ethandoddo/MECH5720_MajorProject/Pitch/sections/01_concept.tex

\vspace{0.5em}
\noindent\textbf{1. Team and roles.} \
\textbf{All four:} research into aperture design methods and validation, experimental data capture, report writing and presentation. \
\textbf{Ethan:} aperture design, integration and further code development. \textbf{Emma and Jayden:} hardware design, integration and code tidying. \textbf{Has:} aperture design and the final GitHub README.

\vspace{0.4em}
\noindent\textbf{2. Goal.}
 \noindent To put a transmissive LCD in the optical path of a Canon DSLR so that software sets the aperture pattern for every frame. The requirement is a dynamic aperture, meaning the aperture pattern changes from one frame to the next. The test is two consecutive frames of a static scene with a different pattern on each, so the frames stay aligned to the pixel.

\vspace{\baselineskip}
 \noindent Once the gates pass, four secondary goals follow, all built from the dynamic aperture. The first is depth estimation. The two frames carry the patterns of a coded aperture pair [\rl{G6}] and a joint deconvolution of the pair recovers a depth map and an all-in-focus image. The second is post-capture refocus, which extends the capture to nine frames, each opening a different sub-aperture [\rl{G3}]. The third is custom bokeh, which repeats the dynamic aperture test with aperture shapes we design ourselves. The fourth is a flutter shutter, which switches the pattern within one exposure. Gate 3 measures whether the panel switches fast enough.

\vspace{\baselineskip}
 \noindent We found a hobbyist build that fits an LCD iris to a camera lens [\rl{G1}, \rl{G2}] and published research that uses controllable apertures for coded imaging [\rl{G4}, \rl{G5}]. Together they show that every part of this plan has been done before. What remains untested is combining them in one camera.

\vspace{0.4em}
\noindent\textbf{3. Approach.}
A defocused point images as a scaled copy of the aperture. That holds only near the lens pupil, so mask position matters.
\begin{itemize}\setlength\itemsep{0pt}
    \item \textbf{Stage 1:} the panel sits against the front of the lens, near the entrance pupil. Edge points see a clipped pattern, so all tests use the image centre.
    \item \textbf{Stage 2}, only if Stage~1 passes all three gates: the panel moves into a slot cut in the 25\,mm extension tube, behind the exit pupil, where it starts to act as a light-field mask. The same patterns at both positions measure the difference.
    \item \textbf{Panel and control:} stripping the backlight and diffuser leaves the transmissive cell. A Raspberry Pi drives it over SPI and fires the shutter.
    \item \textbf{Processing:} a point source at 700, 1000 and 1300\,mm gives PSFs for the open disc and both coded patterns (Lab~3 protocol). Each image patch takes the depth whose PSF pair best explains both frames after Wiener deconvolution. Every capture set includes an open-disc control frame.
\end{itemize}

\noindent\textbf{4. Success criteria.}
\begin{itemize}\setlength\itemsep{0pt}
    \item \textbf{Gate 1, panel acts as an aperture:} a defocused point source matches the displayed pattern with normalised cross-correlation (NCC) $\geq 0.8$. Transmission loss stays at or below 3 stops.
    \item \textbf{Gate 2, coded pair PSFs:} PSF width grows with defocus. The two coded MTFs share no zeros in the target band, while the open-disc MTF shows its expected zeros.
    \item \textbf{Gate 3, dynamic aperture (the requirement):} two consecutive frames of a static point source show the two coded patterns at NCC $\geq 0.8$ each. Open-disc control frames before and after register within one pixel. The measured switching time decides whether a flutter shutter is possible.
    \item \textbf{Depth estimation, first application}, with textured targets at 700, 1000 and 1300\,mm: RMS depth error below 10\,\% of true distance. The all-in-focus image beats the open disc stopped down to the same depth of field on structural similarity index measure (SSIM).
    \item \textbf{Post-capture refocus:} each target reaches peak SSIM against its in-focus reference at its true depth.
    \item \textbf{Custom bokeh:} every out-of-focus highlight reaches NCC $\geq 0.8$ against its displayed shape.
    \item \textbf{Flutter shutter}, only if the switching time allows a useful code in one exposure: deblurring narrows edge width on a moving target.
\end{itemize}

\noindent\textbf{5. Fallback.}
All validation captures at the front of the lens happen before the panel goes into the extension tube. If tube integration damages the LCD panel, those captures form the final deliverable and still address all four goals. If the measured switching time is too slow for a useful code within one exposure, the flutter shutter drops out and the deliverable is the other three goals. Depth estimation is the minimum deliverable, since it needs only two frames and the coded pair.

\vspace{0.4em}
\noindent\textbf{6. Hardware.}\
\textbf{Team builds:} front-of-lens panel mount, slotted 25\,mm extension tube for Stage~2, laser-cut fallback masks, Raspberry Pi display and capture code.\
\textbf{On the loan list:} Adafruit 1.8-inch colour TFT, $128 \times 160$ (\url{https://www.adafruit.com/product/358}). Stripping the backlight is permanent, so the team asks for approval to modify one of the six available.\
\textbf{Already supplied:} Raspberry Pi and the Lab~3 point-source PSF setup. The Canon DSLR and EF lens belong to a team member.\
\textbf{To be acquired on the team's behalf:} three-piece Canon EF and EF-S macro extension tube set, AUD\,\$47.29 (\url{https://www.ebay.com.au/itm/402972099293}), which the team returns after the project. The Stage~2 slot is permanent.
\newpage
