ethandoddo/MECH5720_MajorProject/Report/sections/00_abstract.tex

% Abstract. The brief asks for no jargon, no acronyms, no citations and the key numbers.
% Every red number is a placeholder until the experiments run.
\begin{itemize}
\item We made a camera aperture programmable. We mounted a stripped colour display in front of the lens and an Arduino drew a new pattern on it before each frame.
\item Against laser-cut card masks of the same shapes, the display passed \tbd{X}\,\% of the light and took \tbd{X} milliseconds to switch. Frames stayed within \tbd{0.X} pixels of each other, against \tbd{X} pixels when we swapped card masks by hand.
\item We measured depth to within \tbd{X}\,\% of distance, refocused after capture and cut motion-blur error by \tbd{X}\,\% in dim light.
\item The display suits tasks where the pattern must change between frames. A card mask suits one fixed shape, since it passes more light.
\end{itemize}
