ethandoddo/MECH5720_MajorProject/Report/sections/02_literature_review.tex

% Literature review. The brief: very brief, papers and no websites, and say what we borrow or adapt.
% Plan, one short paragraph each, about 300 words in total. Every key below is in references.bib.
%  1. Coded apertures for depth and deblurring: levin2007coded (one mask cut from card, sparse prior,
%     the Lab 3 mask), zhou2009good (aperture design for deblurring), zhou2009pairs and zhou2011pairsijcv
%     (the pair we display, photomasks in two lenses swapped between shots, a 5 px shift to correct),
%     pentland1987dfd (depth from defocus).
%  2. Programmable apertures: liang2008programmable (liquid crystal array in the aperture, sub-aperture scan
%     and multiplexing, the refocus method), nagahara2010lcos (liquid crystal on silicon with relay optics,
%     argues a transmissive LCD loses too much light and diffracts), bimber2011adaptive (hobby LCD at the
%     aperture plane of a Canon lens, 7:1 contrast, 1/40 s switching), zomet2006lensless (off-the-shelf LCD as
%     a lensless aperture, dark-frame subtraction for leakage), dietz2021lcaperture (colour TFT in front of a
%     lens, 4.7 stops, diffraction ghosts).
%  3. Light fields and refocus: levoy1996lightfield, ng2005lightfield (shift-and-add), veeraraghavan2007dappled.
%  4. Coded exposure: raskar2006coded, agrawal2009codes (code design), cossairt2013when (gains need low light).
%  5. When coding pays: schechner2007multiplexing (multiplexing gain under read noise, Lectures 2A and 3A),
%     mitra2014framework (SNR gain against J/sigma_r^2 with a signal prior, the plot on Lecture 3A slide 17).
%  Lectures 5 and 7 also cite these, not yet in references.bib: Levin et al. 2009 (blind deconvolution, picks
%  the kernel that best explains the photo), FlatCam (Asif et al.), DiffuserCam (Antipa et al. 2018) and
%  PhlatCam (Boominathan et al. 2020, mask optimised for the task, a future-work link for a programmable aperture).
%  Close by stating which ideas we take from which paper. Do not claim novelty over them.
\section{Literature Review}\label{sec:lit}

\tbd{To write. Cite papers alone. See the plan in the comments above.}
