ethandoddo/MECH5720_MajorProject/Report/sections/06_conclusion.tex

% Conclusions and future work. The brief: summarise the work and say what we would do with two more months.
% Keep the summary to the measured numbers. Do not restate the introduction.
% Future work candidates:
%  - multiplexed sub-aperture codes (Liang et al. 2008) for more light per refocus frame
%  - a monochrome panel with no colour filter, which removes 1.6 stops and most of the grid copies
%  - relay optics that image the stop onto the panel (Nagahara et al. 2010), which removes field dependence
%  - a mirrorless body, whose adapter gap holds a mask behind the lens with infinity focus kept
%    (the hobbyist build in PetaPixel, February 2026, did this with a Nokia display)
%  - starting the flutter code from the hot-shoe sync contact through a hot-shoe adapter
%  - dark-frame subtraction for every coded capture if leakage proves to limit depth
\section{Conclusions and Future Work}\label{sec:conclusion}

\tbd{To write.}
