ethandoddo/MECH5720_MajorProject/Pitch/pitch.tex

% main.tex
\documentclass[10pt,a4paper]{article}

\usepackage{silence}
\WarningFilter{siunitx}{Detected the "physics" package}
\usepackage{preamble} % Ensure you have this package or comment it out if not needed
\usepackage{graphicx}
\usepackage{placeins} % Added to control figure floating
\usepackage{float}
\usepackage{ifthen}
\usepackage{textcomp}
\usepackage{pgfgantt}
\usepackage{geometry}
\usepackage{url}
% Let long order-page URLs break anywhere rather than run into the margin
\makeatletter
\g@addto@macro\UrlBreaks{\UrlOrds}
\g@addto@macro\UrlBreaks{%
  \do\a\do\b\do\c\do\d\do\e\do\f\do\g\do\h\do\i\do\j\do\k\do\l\do\m%
  \do\n\do\o\do\p\do\q\do\r\do\s\do\t\do\u\do\v\do\w\do\x\do\y\do\z%
  \do\A\do\B\do\C\do\D\do\E\do\F\do\G\do\H\do\I\do\J\do\K\do\L\do\M%
  \do\N\do\O\do\P\do\Q\do\R\do\S\do\T\do\U\do\V\do\W\do\X\do\Y\do\Z%
  \do\0\do\1\do\2\do\3\do\4\do\5\do\6\do\7\do\8\do\9}
\makeatother
\usepackage{hyperref}
% Reference tag in the body that jumps to that entry in the References list
\newcommand{\rl}[1]{\hyperref[ref:#1]{#1}}
\geometry{
    a4paper,
    left=12mm,
    right=12mm,
    top=2mm,
    bottom=2mm,
}

% Handle missing figures gracefully while keeping black borders on existing ones
\let\origincludegraphics\includegraphics
\renewcommand{\includegraphics}[2][]{%
  \setlength{\fboxsep}{0pt}%
  \setlength{\fboxrule}{0.5pt}%
  \IfFileExists{#2}{%
    \fbox{\origincludegraphics[#1]{#2}}%
  }{%
    \fbox{\begin{minipage}[c][3cm][c]{\linewidth}\centering\scriptsize\ttfamily Missing:\\\detokenize{#2}\end{minipage}}%
  }%
}

\pagestyle{empty}
\linespread{1}

\begin{document}

\noindent\makebox[\textwidth][s]{{\LARGE \bfseries Major Project Pitch:} {\Large \color{black!70} Dynamic aperture control with a transmissive LCD }}\\[0.3cm]
\noindent
\begin{tabular*}{\textwidth}{@{\extracolsep{\fill}} c c c c @{}}
    490480278 & 500468995 & 530477149 & 530504892 \\
\end{tabular*}\vspace{0.1cm}
\hrule
\input{sections/01_concept}
\input{sections/02_gantt}
\input{sections/03_appendix}

\end{document}
