ethandoddo/MECH5720_MajorProject/Pitch/sections/02_gantt.tex

% \vspace{-2em}
% \section*{Project schedule \& division of labour}

% \begin{center}
% \definecolor{coral}{HTML}{FF7F50}
% \resizebox{\textwidth}{!}{
% \begin{ganttchart}[
%     x unit=1.6cm,
%     y unit title=0.6cm,
%     y unit chart=0.5cm,
%     title label font=\small\bfseries,
%     title label node/.append style={text height=1.5ex, text depth=0ex, anchor=center},
%     bar label font=\footnotesize,
%     bar label node/.append style={align=left, text width=4.5cm},
%     milestone label font=\footnotesize\itshape,
%     milestone label node/.append style={align=left, text width=4.5cm},
%     bar height=0.6,
%     bar top shift=0.2,
%     bar/.append style={fill=blue!40},
%     milestone/.append style={fill=green!70, draw=green!40!black, xscale=0.25, yscale=0.5},
%     canvas/.append style={fill=none},
%     vgrid={*1{draw=black!10}}, hgrid]{1}{7}
%     \gantttitle{MSB}{1} \gantttitle{W8}{1} \gantttitle{W9}{1} \gantttitle{W10}{1} \gantttitle{W11}{1} \gantttitle{W12}{1} \gantttitle{W13}{1} \\
%     \node[anchor=east, font=\small\bfseries, text height=1.5ex, text depth=0ex] at (0, -0.15cm) {Week};

%     \ganttset{bar/.append style={fill=blue!40}}
%     \ganttbar[name=t1]{\textbf{Phase 1}}{1}{2} \\

%     \ganttset{bar/.append style={fill=blue!10}}
%     \ganttbar[name=p1]{Subtask 1.1}{1}{1} \\
%     \ganttbar[name=p2]{Subtask 1.2}{1}{2} \\

%     \ganttset{bar/.append style={fill=coral!70}}
%     \ganttbar[name=t2]{\textbf{Phase 2}}{2}{4} \\

%     \ganttset{bar/.append style={fill=blue!10}}
%     \ganttbar[name=p3]{Subtask 2.1}{2}{3} \\
%     \ganttbar[name=p4]{Subtask 2.2}{3}{4} \\

%     \ganttset{bar/.append style={fill=blue!40}}
%     \ganttbar[name=t3]{\textbf{Phase 3}}{3}{5} \\

%     \ganttset{bar/.append style={fill=blue!10}}
%     \ganttbar[name=p5]{Subtask 3.1}{3}{4} \\
%     \ganttbar[name=p6]{Subtask 3.2}{4}{5} \\

%     \ganttset{bar/.append style={fill=coral!70}}
%     \ganttbar[name=t4]{\textbf{Phase 4}}{5}{6} \\

%     \ganttset{bar/.append style={fill=blue!10}}
%     \ganttbar[name=p7]{Subtask 4.1}{5}{6} \\

%     \ganttset{bar/.append style={fill=blue!40}}
%     \ganttbar[name=t5]{\textbf{Phase 5}}{6}{7} \\

%     \ganttset{bar/.append style={fill=blue!10}}
%     \ganttbar[name=p8]{Subtask 5.1}{6}{6} \\
%     \ganttbar[name=p9]{Subtask 5.2}{7}{7} \\

%     \ganttmilestone[name=m1]{\textbf{D1: Project Pitch}}{2} \\
%     \ganttmilestone[name=m2]{\textbf{D2: Lightning Talk}}{7} \\
%     \ganttmilestone[name=m3]{\textbf{D3: Final Report}}{7}

%     \ganttlink{t1}{t2}
%     \ganttlink{t2}{t3}
%     \ganttlink{t3}{t4}
%     \ganttlink{t4}{t5}

% \end{ganttchart}
% }
% \end{center}

% \vspace{0.5em}
% \textbf{Workload distribution:}
% [Ensure you briefly justify the workload distribution above and confirm that all members contribute roughly equally to the design, implementation, and reporting phases of the project.]
