ethandoddo/MECH5720_MajorProject/code/assets/sprites/binary/knight/knight_binary_walk.gif

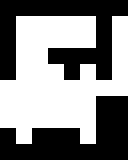
code/assets/sprites/binary/knight/knight_binary_walk.gif
