ethandoddo/MECH5720_MajorProject/code/assets/sprites/binary/link/link_binary_attack_2.png

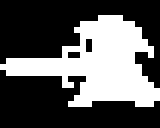
code/assets/sprites/binary/link/link_binary_attack_2.png
