ethandoddo/MECH5720_MajorProject/code/assets/sprites/binary/link/link_binary_walk.gif

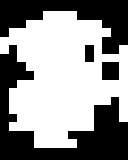
code/assets/sprites/binary/link/link_binary_walk.gif
