ethandoddo/MECH5720_MajorProject/code/assets/sprites/binary/mario/mario_binary_walk.gif

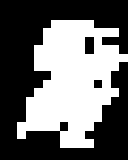
code/assets/sprites/binary/mario/mario_binary_walk.gif
