ethandoddo/MECH5720_MajorProject/code/assets/sprites/binary/mario/mario_binary_walk_2.png

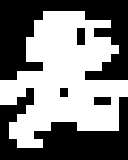
code/assets/sprites/binary/mario/mario_binary_walk_2.png
