ethandoddo/MECH5720_MajorProject/code/assets/sprites/binary/terraria/terraria_binary_mine.gif

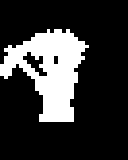
code/assets/sprites/binary/terraria/terraria_binary_mine.gif
