ethandoddo/MECH5720_MajorProject/code/assets/sprites/binary/terraria/terraria_binary_mine_2.png

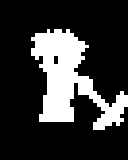
code/assets/sprites/binary/terraria/terraria_binary_mine_2.png
