ethandoddo/MECH5720_MajorProject/code/assets/sprites/grey/knight/knight_grey_walk.gif

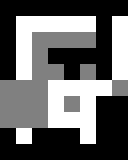
code/assets/sprites/grey/knight/knight_grey_walk.gif
