ethandoddo/MECH5720_MajorProject/code/assets/sprites/grey/link/link_grey_attack.gif

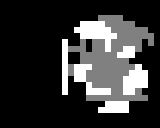
code/assets/sprites/grey/link/link_grey_attack.gif
