ethandoddo/MECH5720_MajorProject/code/assets/sprites/grey/link/link_grey_walk.gif

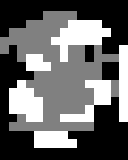
code/assets/sprites/grey/link/link_grey_walk.gif
