ethandoddo/MECH5720_MajorProject/code/assets/sprites/grey/link/link_grey_walk_2.png

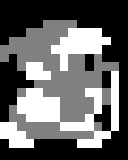
code/assets/sprites/grey/link/link_grey_walk_2.png
