ethandoddo/MECH5720_MajorProject/code/captures/bokeh_inside_lens/knight_binary_walk_1_5.5mm_offset_5-49mm.jpg

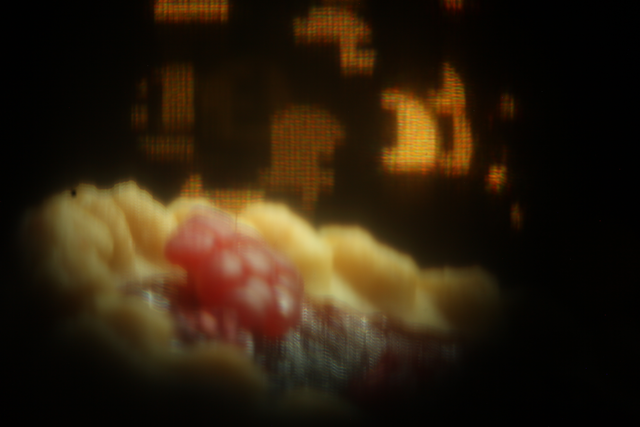
code/captures/bokeh_inside_lens/knight_binary_walk_1_5.5mm_offset_5-49mm.jpg
