ethandoddo/MECH5720_MajorProject/code/captures/bokeh_inside_lens/link_binary_attack_2_5.5mm_offset_5-49mm.jpg

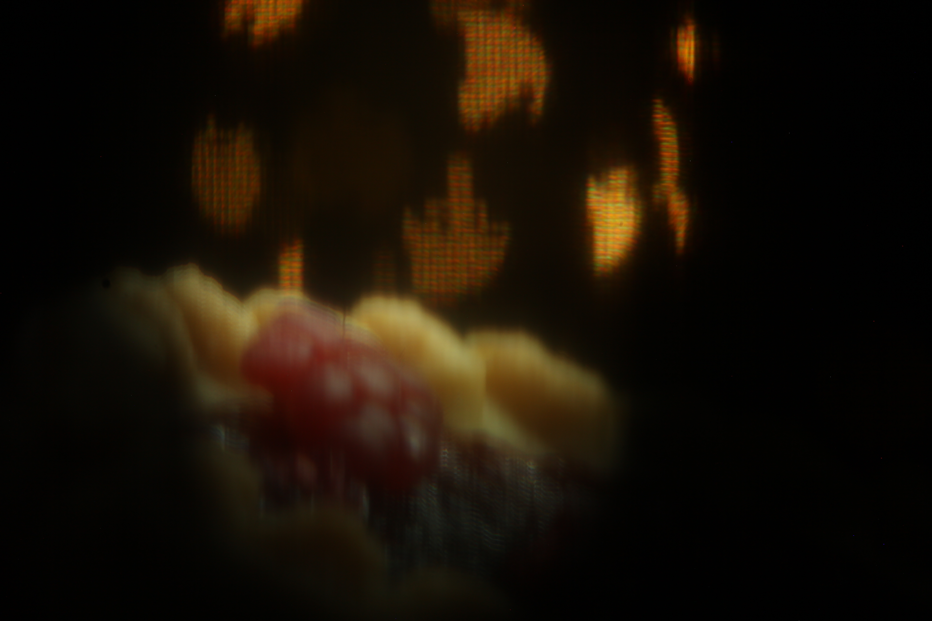
code/captures/bokeh_inside_lens/link_binary_attack_2_5.5mm_offset_5-49mm.jpg
