ethandoddo/MECH5720_MajorProject/code/captures/bokeh_inside_lens/mario_binary_walk_3_5.5mm_offset_5-49mm.jpg

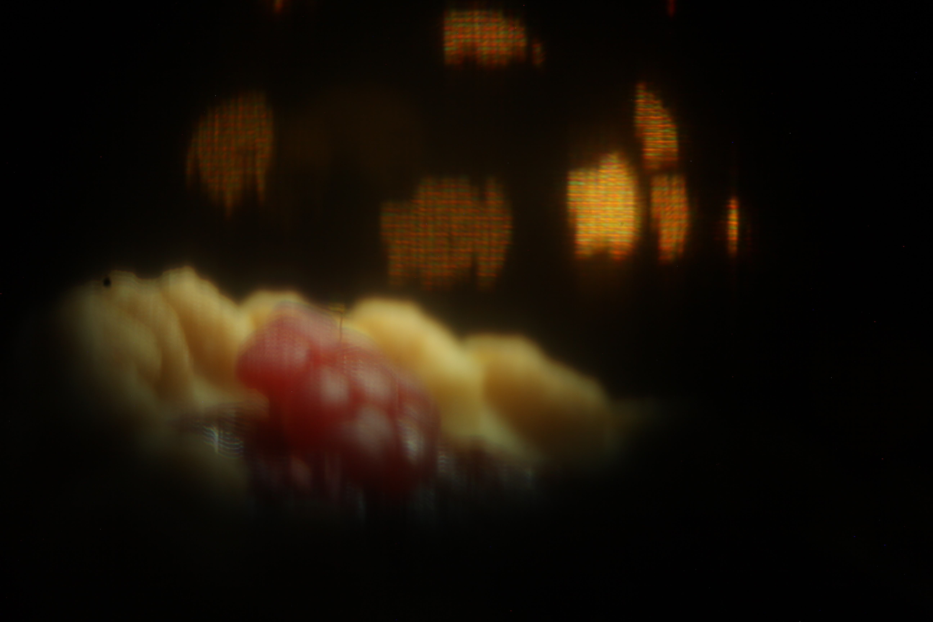
code/captures/bokeh_inside_lens/mario_binary_walk_3_5.5mm_offset_5-49mm.jpg
