ethandoddo/MECH5720_MajorProject/code/captures/bokeh_inside_lens/zhou_a_5.5mm_offset_5-34mm.jpg

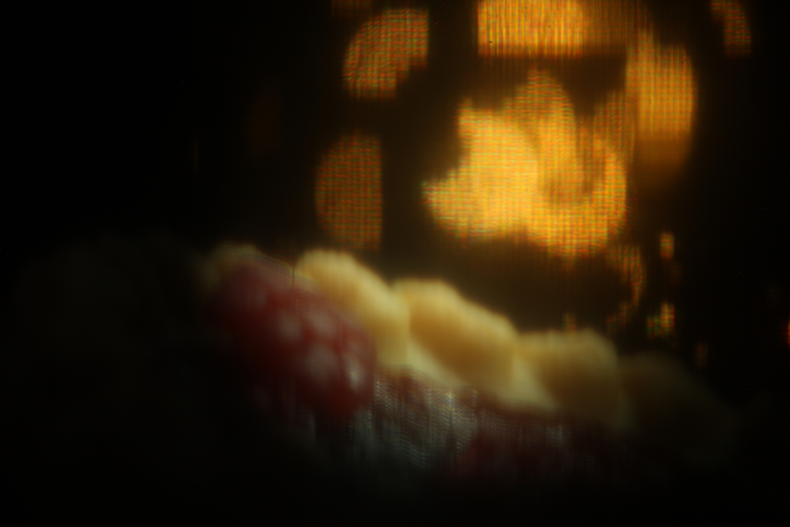
code/captures/bokeh_inside_lens/zhou_a_5.5mm_offset_5-34mm.jpg
