ethandoddo/MECH5720_MajorProject/code/captures/bokeh_outside_lens/knight_binary_walk_1_9.5mm_offset_11-134mm.jpg

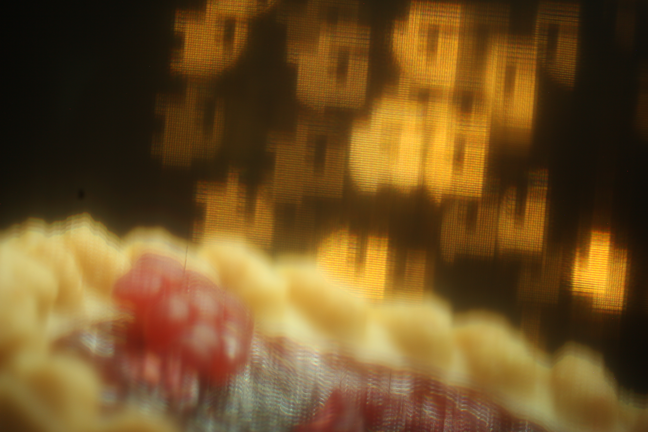
code/captures/bokeh_outside_lens/knight_binary_walk_1_9.5mm_offset_11-134mm.jpg
