ethandoddo/MECH5720_MajorProject/code/captures/bokeh_outside_lens/zhou_b_9.5mm_offset_11-134mm.jpg

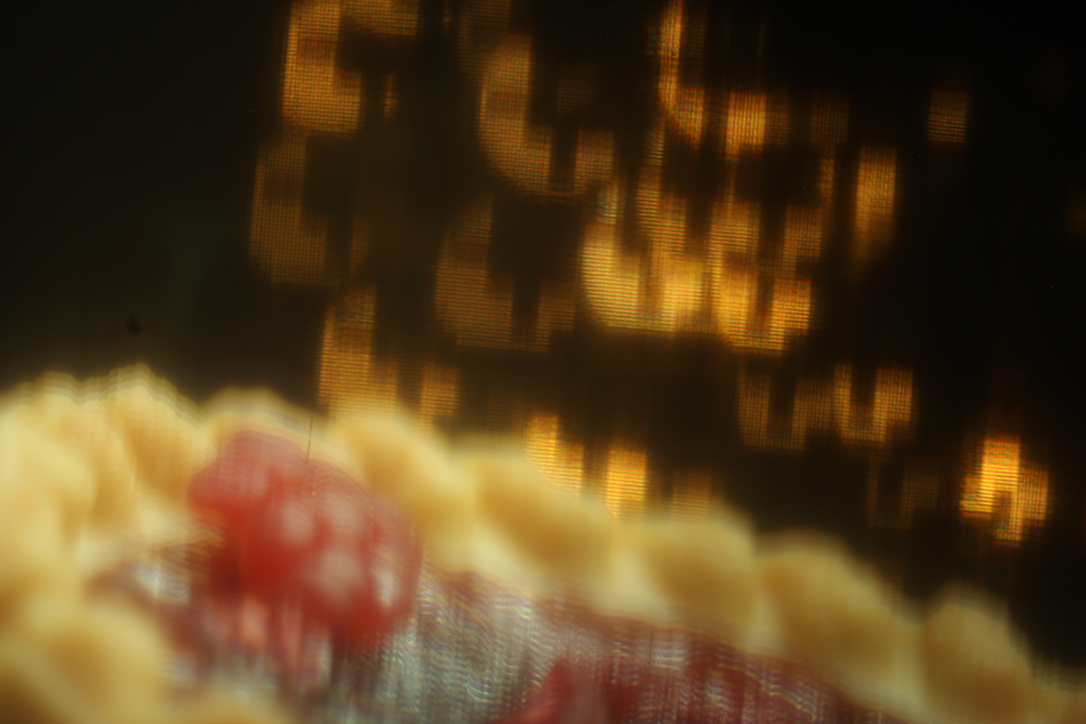
code/captures/bokeh_outside_lens/zhou_b_9.5mm_offset_11-134mm.jpg
