ethandoddo/MECH5720_MajorProject/code/captures/flutter_5s_ISO100_f5.6_inside_lens/f56_run1_lcd_inside/95_baselines.png

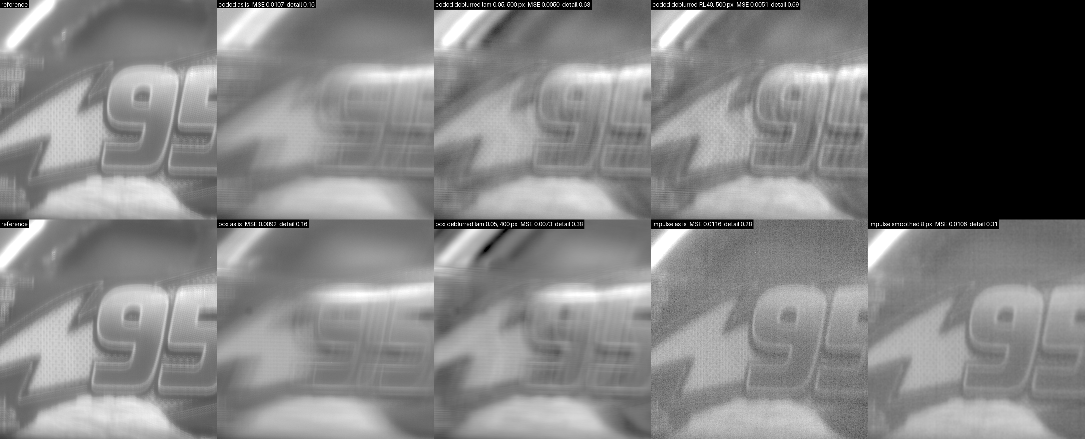
code/captures/flutter_5s_ISO100_f5.6_inside_lens/f56_run1_lcd_inside/95_baselines.png
