ethandoddo/MECH5720_MajorProject/code/captures/flutter_5s_ISO100_f5.6_inside_lens/f56_run1_lcd_inside/f56_run1_lcd_inside_100ms_invert_box.png

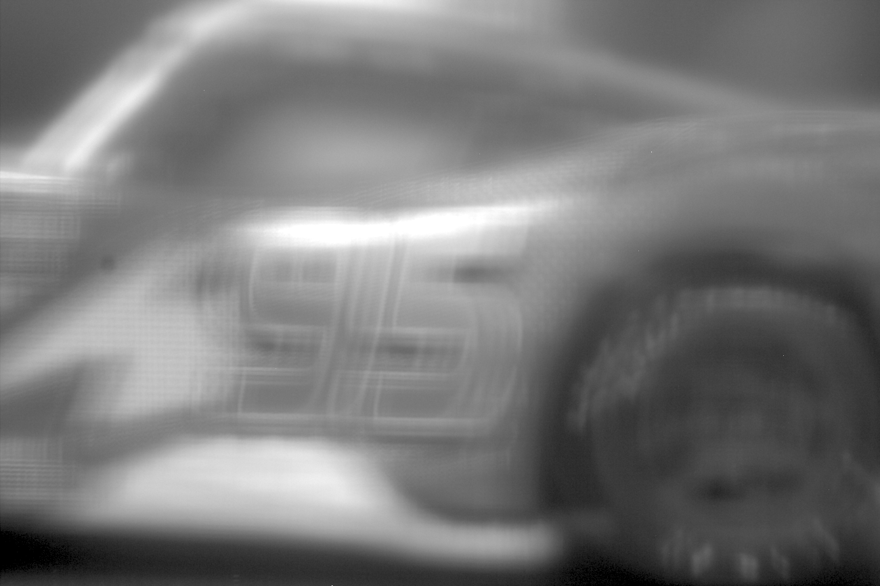
code/captures/flutter_5s_ISO100_f5.6_inside_lens/f56_run1_lcd_inside/f56_run1_lcd_inside_100ms_invert_box.png
