ethandoddo/MECH5720_MajorProject/code/captures/flutter_5s_ISO100_f5.6_outside_lens/95_compare.png

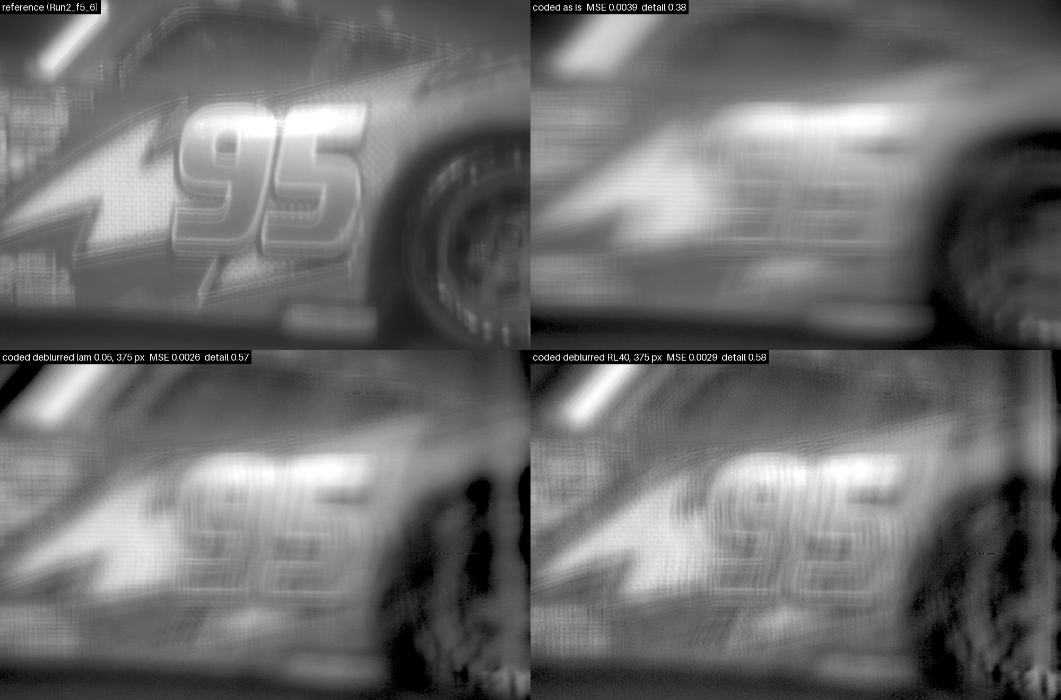
code/captures/flutter_5s_ISO100_f5.6_outside_lens/95_compare.png
