ethandoddo/MECH5720_MajorProject/code/captures/flutter_5s_ISO100_f5.6_outside_lens/deblurred_best_lam0.05_375px.png

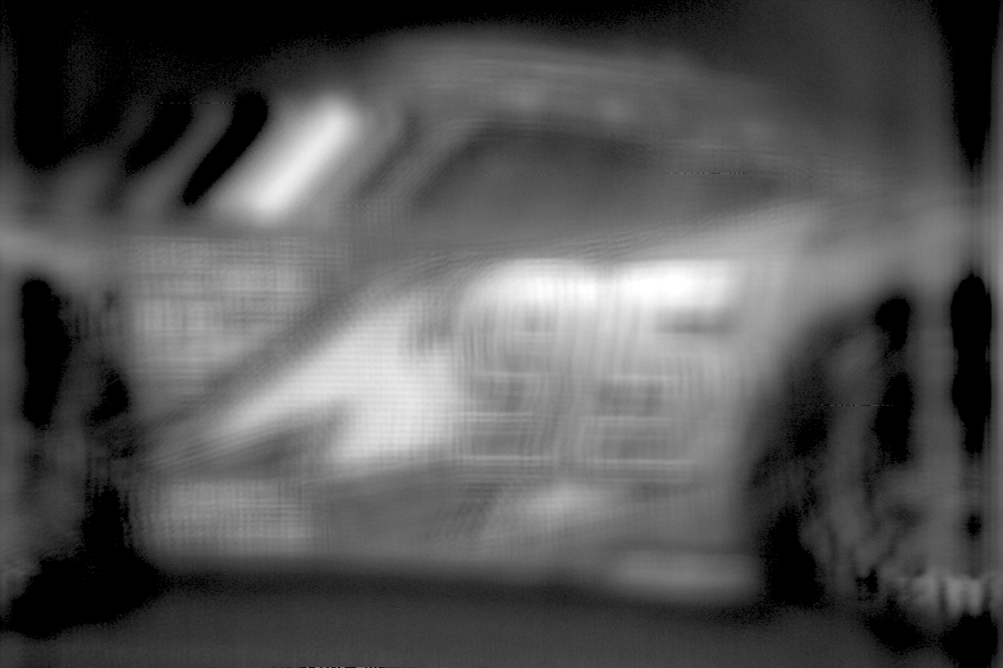
code/captures/flutter_5s_ISO100_f5.6_outside_lens/deblurred_best_lam0.05_375px.png
