ethandoddo/MECH5720_MajorProject/code/captures/flutter_5s_ISO100_f11_inside_lens/f11_run1_lcd_inside_2/compare.png

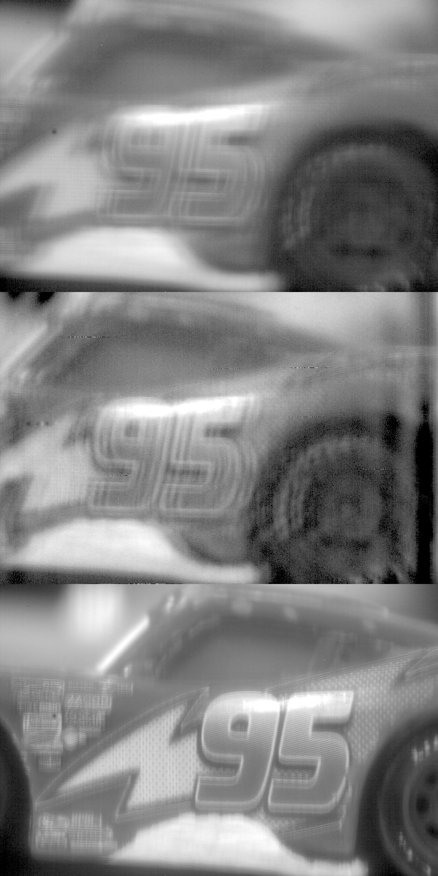
code/captures/flutter_5s_ISO100_f11_inside_lens/f11_run1_lcd_inside_2/compare.png
