ethandoddo/MECH5720_MajorProject/code/captures/flutter_5s_ISO100_f11_inside_lens/f22_run1_lcd_inside/95_baselines.png

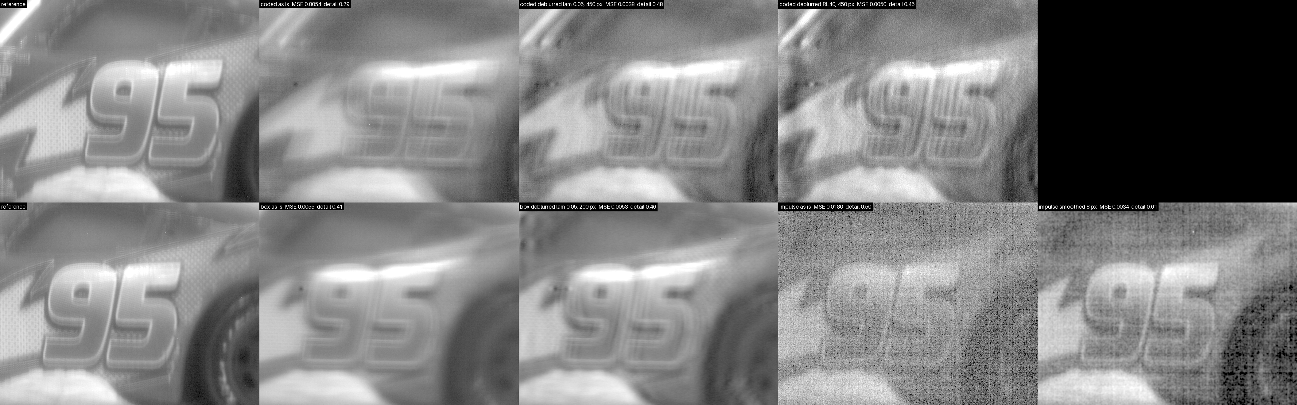
code/captures/flutter_5s_ISO100_f11_inside_lens/f22_run1_lcd_inside/95_baselines.png
