ethandoddo/MECH5720_MajorProject/code/captures/flutter_5s_ISO100_f11_outside_lens/compare.png

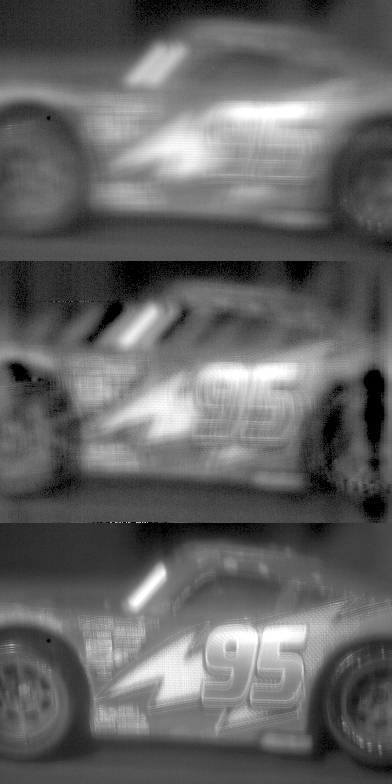
code/captures/flutter_5s_ISO100_f11_outside_lens/compare.png
