ethandoddo/MECH5720_MajorProject/code/captures/flutter_5s_ISO100_f11_outside_lens/deblurred_RL40_475px.png

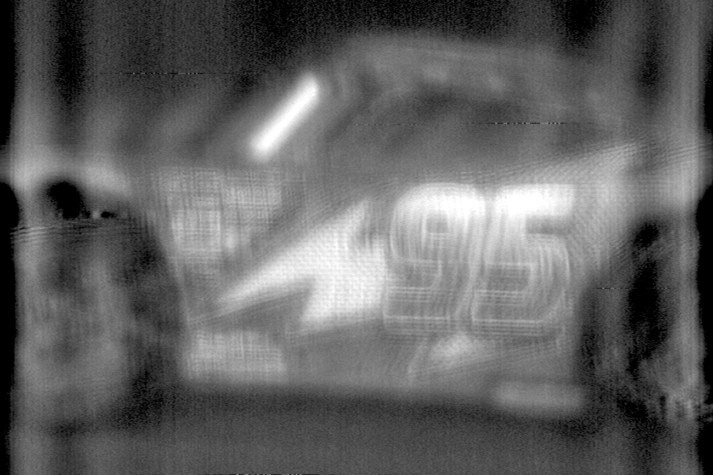
code/captures/flutter_5s_ISO100_f11_outside_lens/deblurred_RL40_475px.png
