ethandoddo/MECH5720_MajorProject/code/captures/flutter_5s_ISO100_f22_inside_lens/f22_inside_lcd_run2/f22_inside_lcd_run2_100ms_invert_coded_lam0.05_400px.png

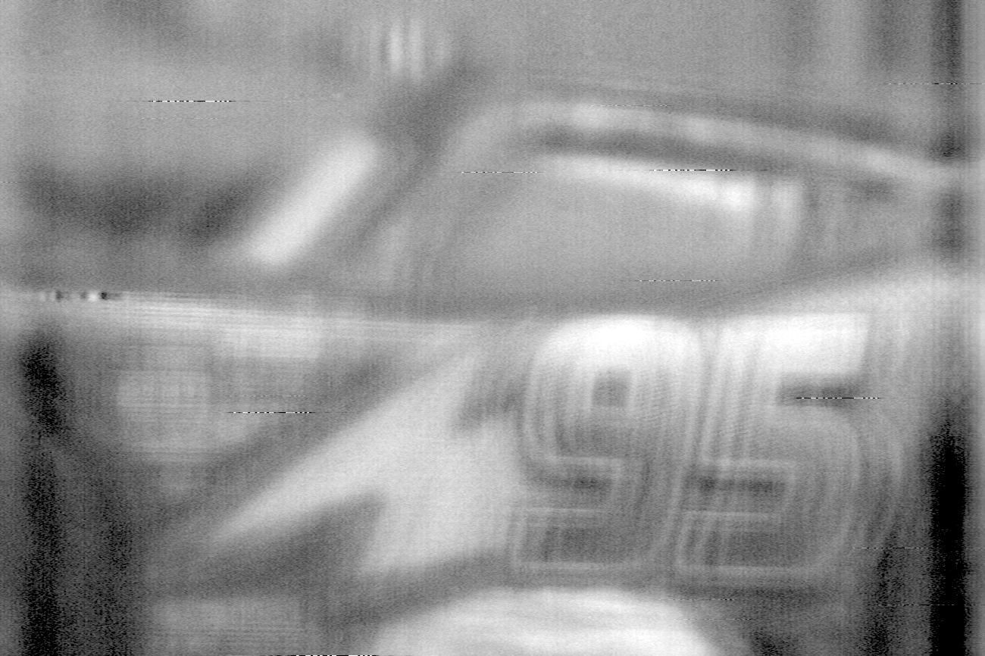
code/captures/flutter_5s_ISO100_f22_inside_lens/f22_inside_lcd_run2/f22_inside_lcd_run2_100ms_invert_coded_lam0.05_400px.png
