ethandoddo/MECH5720_MajorProject/code/captures/flutter_5s_ISO100_f22_inside_lens/f22_lcd_inside/f22_lcd_inside_100ms_invert_box_RL40_200px.png

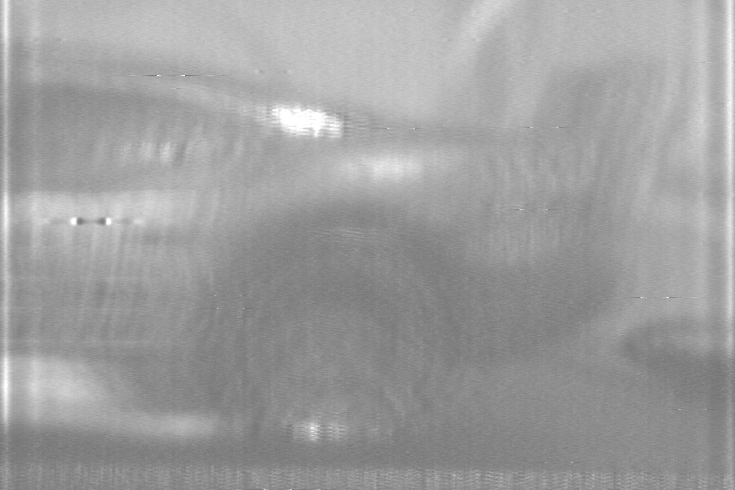
code/captures/flutter_5s_ISO100_f22_inside_lens/f22_lcd_inside/f22_lcd_inside_100ms_invert_box_RL40_200px.png
