ethandoddo/MECH5720_MajorProject/code/captures/flutter_5s_ISO100_f22_outside_lens/deblurred_best_lam0.5_250px.png

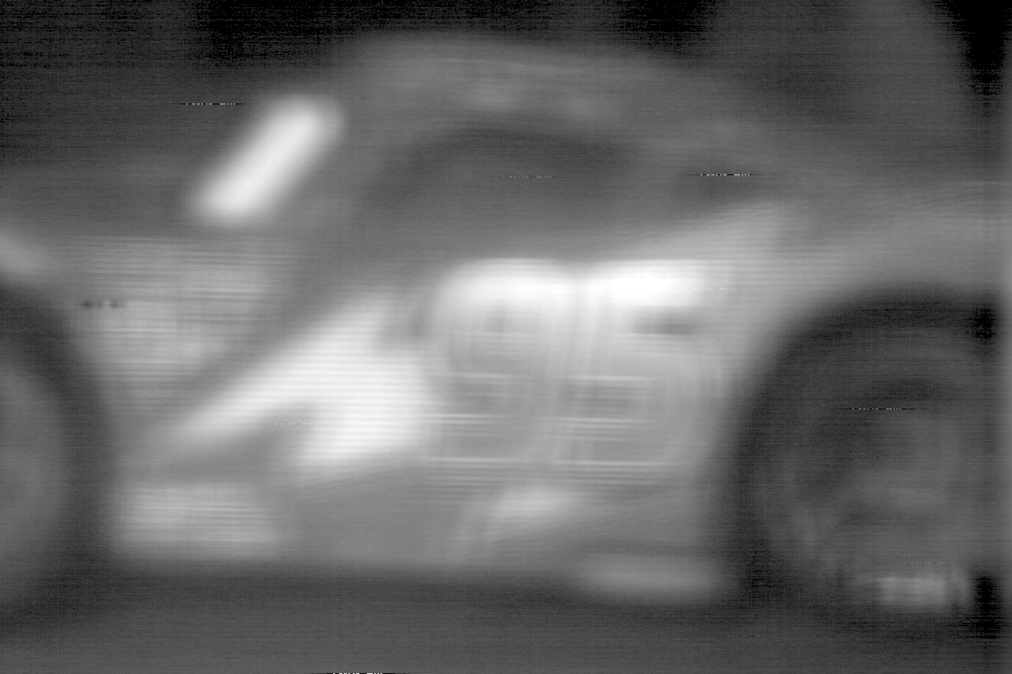
code/captures/flutter_5s_ISO100_f22_outside_lens/deblurred_best_lam0.5_250px.png
