ethandoddo/MECH5720_MajorProject/Pitch/Images/apertures_by_goal.png

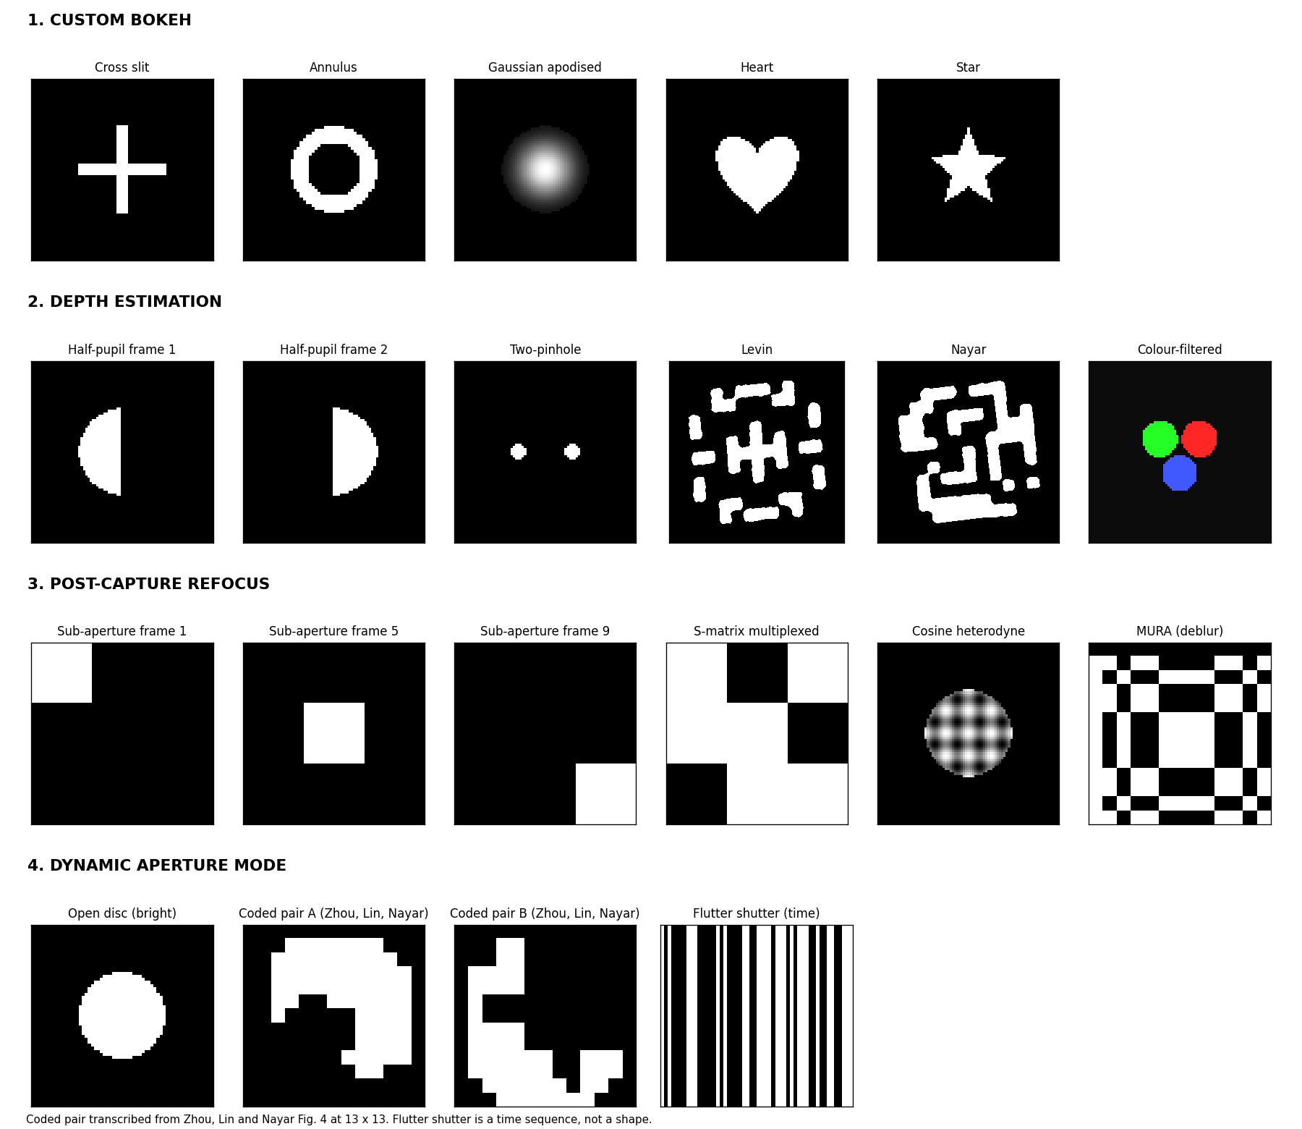
Pitch/Images/apertures_by_goal.png
