ethandoddo/MECH5720_MajorProject/code/aperture/rig/camera.py

"""Camera backends. capture(stem) writes one frame and returns the files it wrote, raw first.

  gphoto  a Canon EOS 60D on USB through the gphoto2 command line tool. The camera
          sits in manual exposure and manual focus, with the file quality set on the
          body. RAW+JPEG on the body gives a CR2 for processing and a JPEG the camera
          view can show at once
  dummy   writes whatever the display is showing as a PNG, so a whole sequence can run
          on a laptop with nothing plugged in

capture_start(stem) runs capture(stem) in its own thread and returns a job whose wait()
gives the files, so the server can read the panel's flutter trace while the shutter is
open. shutter_s() reads the body's shutter speed, which a flutter frame on M needs to be
at least lead + code.
"""
import re
import shutil
import subprocess
import threading
from pathlib import Path

from aperture import config as cfg
from aperture import flutter

RAW_EXT = {".cr2", ".dng", ".nef", ".arw", ".raw"}
SETTING_NAMES = ("iso", "shutterspeed", "aperture")


class CameraError(RuntimeError):
    pass


def shutter_seconds(current):
    """the shutter speed the body reports, in seconds; CameraError when it is not a time, as on B"""
    s = flutter.shutter_s(current)
    if s is None:
        raise CameraError(f"the shutter speed is {current!r}, not a time: turn the mode dial to M")
    return s


class Camera:
    name = "base"

    def capture(self, stem):
        """stem is a path without extension; returns the files written, the raw one first"""
        raise NotImplementedError

    def capture_start(self, stem):
        """capture(stem) in its own thread, so the server can read the panel's flutter trace
        while the shutter is open; returns a job whose wait() gives the files"""
        return ThreadJob(lambda: self.capture(stem))

    def shutter_s(self):
        """the body's shutter speed in seconds"""
        raise NotImplementedError

    def configure(self, settings):
        return {}

    def choices(self):
        """{"iso": {"current": "100", "choices": [...]}, ...} for the settings the GUI offers"""
        return {}

    def describe(self):
        return {"camera": self.name}


class ThreadJob:
    """a capture that runs in its own thread; wait() returns the files or raises"""

    def __init__(self, fn):
        self.files = None
        self.error = None
        self._thread = threading.Thread(target=self._run, args=(fn,), daemon=True)
        self._thread.start()

    def _run(self, fn):
        try:
            self.files = fn()
        except Exception as e:
            self.error = e

    def wait(self, timeout=None):
        self._thread.join(timeout)
        if self._thread.is_alive():
            raise CameraError("the exposure did not finish")
        if self.error:
            raise self.error if isinstance(self.error, CameraError) else CameraError(str(self.error))
        return self.files


class DummyCamera(Camera):
    name = "dummy"

    def __init__(self, display):
        self.display = display
        self.settings = {"iso": "100", "shutterspeed": "1/30", "aperture": "1.8"}

    def capture(self, stem):
        path = Path(str(stem) + ".png")
        path.parent.mkdir(parents=True, exist_ok=True)
        img = self.display.last
        if img is None:
            raise CameraError("nothing has been shown yet")
        img.save(path)
        return [path]

    def shutter_s(self):
        return shutter_seconds(self.settings["shutterspeed"])

    def configure(self, settings):
        self.settings.update(settings)
        return settings

    def choices(self):
        opts = {
            "iso": ["100", "200", "400", "800", "1600"],
            "shutterspeed": ["1/250", "1/125", "1/60", "1/30", "1/15", "1/8", "1/4", "1/2", "1", "2", "4",
                             "5", "8", "15", "30"],
            "aperture": ["1.8", "2.8", "4", "5.6", "8"],
        }
        return {k: {"current": self.settings[k], "choices": v} for k, v in opts.items()}


class GPhotoCamera(Camera):
    name = "gphoto"

    def __init__(self, binary=None):
        self.bin = binary or cfg.GPHOTO_BIN
        if shutil.which(self.bin) is None:
            raise CameraError(f"{self.bin} not found; sudo apt install gphoto2")
        # the desktop's volume monitor grabs the camera as a USB drive and gphoto2 then
        # cannot claim it, so make sure it is out of the way before the first capture
        subprocess.run(["pkill", "-f", "gvfs-gphoto2-volume-monitor"], capture_output=True)
        subprocess.run(["pkill", "-f", "gvfsd-gphoto2"], capture_output=True)

    def _run(self, *args, timeout=cfg.CAPTURE_TIMEOUT_S):
        proc = subprocess.run([self.bin, *args], capture_output=True, text=True, timeout=timeout)
        if proc.returncode != 0:
            raise CameraError(proc.stderr.strip() or proc.stdout.strip() or f"gphoto2 exit {proc.returncode}")
        return proc.stdout

    def describe(self):
        try:
            return {"camera": self.name, "summary": self._run("--summary", timeout=20)}
        except CameraError as e:
            return {"camera": self.name, "error": str(e)}

    def list_config(self):
        return self._run("--list-all-config", timeout=30)

    def configure(self, settings):
        """settings like {"iso": "100", "shutterspeed": "1/30"}; names as --list-config reports them"""
        args = []
        for k, v in settings.items():
            args += ["--set-config", f"{k}={v}"]
        if args:
            self._run(*args, timeout=30)
        return settings

    def choices(self):
        out = {}
        for name in SETTING_NAMES:
            try:
                text = self._run("--get-config", name, timeout=20)
            except CameraError:
                continue
            current = re.search(r"^Current:\s*(.*)$", text, re.M)
            opts = re.findall(r"^Choice:\s*\d+\s+(.*)$", text, re.M)
            out[name] = {"current": current.group(1).strip() if current else None, "choices": opts}
        return out

    def capture(self, stem):
        stem = Path(stem)
        stem.parent.mkdir(parents=True, exist_ok=True)
        # %C is the camera's own extension, so RAW+JPEG on the body gives two files
        template = str(stem) + ".%C"
        self._run("--capture-image-and-download", "--filename", template, "--force-overwrite")
        return self._written(stem)

    @staticmethod
    def _written(stem):
        written = [p for p in stem.parent.glob(stem.name + ".*") if not p.name.endswith("_preview.jpg")]
        if not written:
            raise CameraError("gphoto2 reported success but no file appeared")
        return sorted(written, key=lambda p: (p.suffix.lower() not in RAW_EXT, p.name))

    def shutter_s(self):
        """the shutter speed the body reads now; the 60D has no time on B, so that one raises"""
        text = self._run("--get-config", "shutterspeed", timeout=20)
        m = re.search(r"^Current:\s*(.*)$", text, re.M)
        return shutter_seconds(m.group(1).strip() if m else "")


def to_dng(raw):
    """a DNG beside a CR2 through dnglab, without the CR2 embedded in it. The raw pixels and the
    BlackLevel tag match the CR2, so MATLAB reads the same numbers. LibRaw reads these DNGs
    with a black level 40 to 100 counts too high, so rawpy and gates.py stay on the CR2"""
    raw = Path(raw)
    out = raw.with_suffix(".dng")
    if shutil.which(cfg.DNGLAB_BIN) is None:
        raise CameraError(f"{cfg.DNGLAB_BIN} not found; see Laptop setup in the README")
    proc = subprocess.run([cfg.DNGLAB_BIN, "convert", "--embed-raw", "false", "--override", str(raw), str(out)],
                          capture_output=True, text=True, timeout=120)
    if proc.returncode != 0 or not out.exists():
        raise CameraError(f"dnglab could not convert {raw.name}: {proc.stderr.strip()[-300:]}")
    return out


def add_dngs(files):
    """files from capture() with a DNG added after each CR2 when SAVE_DNG is on"""
    out = list(files)
    if cfg.SAVE_DNG:
        for f in files:
            if f.suffix.lower() == ".cr2":
                out.append(to_dng(f))
    return out


def open_camera(name, display=None):
    if name == "gphoto":
        return GPhotoCamera()
    if name == "dummy":
        return DummyCamera(display)
    raise KeyError(name)
