ethandoddo/MECH5720_MajorProject/(commit log)

2026-09-22 Rename Report folder to Pitch
2026-09-24 Makign the pitch report more clear and concise
2026-09-25 Add the capture and gate code, restructure the pitch around per-frame switching
    Pitch
    - Retitle to dynamic aperture control with a transmissive LCD
    - Make per-frame aperture switching the priority goal and list depth
    estimation, custom bokeh, post-capture refocus and the flutter shutter
    as its applications in order of difficulty
    - Add Gate 3 for per-frame switching with a registration check on the
    open control frames, and rename the depth criterion as the first
    application
    - Rewrite the fallback as a scope ladder instead of a second build
    - Drop the aperture figure and hardware order pages from the appendix,
    add the Zhou, Lin and Nayar 2009 reference, tighten the wording to fit
    o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
    [camera.py, camview_capture.py, capture_series.py, config.py, display.py, gates.py, liveview.py]
2026-10-12 Tighten the pitch wording and ignore slides and prose backups
2026-10-12 Replace the Raspberry Pi with a laptop plus an Arduino or ESP32
    The laptop runs server.py with gphoto2 and streams each pattern over USB serial to
    arduino/aperture_panel, which writes it to the ST7735R as run lengths with no frame
    buffer. The arduino display backend finds the board, waits for its banner and returns
    the acknowledgement time as shown_s. The st7735 Pi backend stays as a dormant option.
    One requirements file replaces the Pi and laptop pair. The README covers Ubuntu setup,
    wiring for an Uno and the ESP32 families and the first-run checks.
    [aperture_panel.ino, camview_capture.py, capture_series.py, config.py, display.py, gates.py, server.py, show.py]
2026-10-15 Stop live view draining the battery; GIF playback, rotation, DNGs and Uno flow control
    Live view now ends itself when no window has taken a frame for 30 s or after
    10 min in one go, closing the window turns it off, Ctrl-C on the server brings
    the mirror down, and a stream that dies is reaped with the checkbox cleared.
    The server terminal prints why it stopped. LIVEVIEW_IDLE_S and LIVEVIEW_MAX_S
    in config.py set the times.
    Also brings in the work since the last commit: protocol 2 for the Arduino
    sketch with credit flow control under the Uno's 64 byte buffer, a DNG beside
    each CR2 through dnglab, GIF playback and an images sequence, image size and
    rotation of any pattern, transparent sprites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
2026-10-15 Add the flutter shutter and the Experiments window
    The panel is now the shutter: the camera sits open in bulb mode while the board
    plays a binary code on the panel from its own clock and reads a photodiode. The
    sketch gains an invert command and the play command (protocol 3). flutter.py
    designs the code. server.py runs steps with prompts, bulb frames and the trace,
    with /sequence/go and /sequence/stop. camview_capture.py gets an Experiments
    window with Depth, Refocus, Bokeh and Flutter tabs and a smaller camera view.
    patterns.py takes scan5_12 for a 5 x 5 scan. The README gains a step by step.
    [aperture_panel.ino, camera.py, camview_capture.py, capture_series.py, config.py, display.py, flutter.py, patterns.py]
2026-10-19 Flutter tab: step pop-ups, Capture, file names and no photodiode
    - Run takes impulse first, so the dial turns once from M to B, and pauses
    before the first frame of each capture with a pop-up that says what to set up
    - Switch test is now LCD only flutter shutter and follows Repeats
    - Capture takes a plain photo with the panel white, at the camera's own
    settings or at ISO, shutter and aperture picked on the tab
    - Name box for the file names, numbered so a download never replaces an
    earlier one
    - Photodiode removed from the sketch, display.py, server.py and the window.
    The sketch is protocol 4, so the Uno needs it uploaded again
    - Lead 1000 ms and Tail 200 ms by default. Bulb opens and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
    [aperture_panel.ino, camview_capture.py, capture_series.py, config.py, display.py, server.py]
2026-10-22 Flutter on M, light-level results at f/5.6, f/11 and f/22, and depth pair pickers
    Flutter shutter:
    - Every flutter frame is one photo on M at the camera's shutter speed, at least lead + code,
    in place of bulb mode (camera.py, server.py, config.py, flutter.py, capture_series.py and
    the Flutter tab in camview_capture.py).
    - flutter_deblur.py deblurs a coded frame with its trace and scores it against the reference.
    - flutter_score.py checks a run (manifest, traces, raw level, clipping, EXIF), sweeps the coded
    and box photos over blur length with the car moving left, scores coded, box and impulse
    against the reference (MSE, NCC, detail) with the f/11 settings and at each photo's best
    s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
    [data.csv]
2026-10-26 Flutter results with the LCD inside the lens, and outside-lens folder names
    The f/5.6, f/11 and f/22 results folders become flutter_5s_ISO100_<f>_outside_lens.
    New flutter_5s_ISO100_f5.6_inside_lens and flutter_5s_ISO100_f11_inside_lens hold the
    three runs with the LCD inside the extension tube: traces, manifests, flutter_score.py
    scores and pictures, with data.md and data.csv. f22_run1_lcd_inside was shot at f/11
    (EXIF), so it sits in the f/11 folder as a repeat. Raw photos stay off git as before.
    The f/22 data.md notes the Run2_f22 coded and Run3_f22 box pair the report now uses.
    README and flutter_score.py point at the new folder names, and the f/5.6 and f/22
    score.py load their template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
    [data.csv]
2026-10-28 Flutter at f/22 with the LCD inside the lens: the retake and the first attempt
    [data.csv]
2026-10-28 f/22 inside-lens data.md: tidy the wording
2026-10-28 Bokeh captures with the LCD inside and outside the lens
2026-10-29 Call the flutter deconvolution a Wiener filter, as the lectures do
    Lec 5 p29 names W = H*/(|H|^2 + K) the Wiener filter. The row by row
    deconvolution in flutter_deblur.py is that filter with a constant K, so
    the docstrings, the --lam help and the README now use the lecture name
    in place of Tikhonov and regularised least squares. No behaviour change.
